708yamaguchi/pr2_fingertip_sensors/scripts/README.md

Here, to avoid duplicate expressions, multiple topic names are summarized by abbreviating them as follows:
  - `{l_r}`: `l` or `r`
  - `{part}`: `pfs_a_front`, `pfs_b_top`, `pfs_b_back`, `pfs_b_left` or `pfs_b_right`
  - `{sensor_num}`: the number of sensors on the each PFS board

# parse_pr2.py

  This node parses PFS sensor data by combining two consecutive topics.

## Subscribe topics

  ROS topics output from PR2 gripper MCB.

  - `/pressure/{l_r}_gripper_motor` (`pr2_msgs/PressureState`)

## Publish topics

  Parsed PFS topics.

  - `/pfs/{l_r}_gripper/{l_r}_fingertip` (`pr2_fingertip_sensors/PR2FingertipSensor`)

# convert_pfs.py

  This node converts parsed PFS data into ROS topics decomposed for each sensor.
  This node publishes
  - force data for each PFS board (6 axis, unit: [N])
  - imu data for each fingertip (6 axis, unit: [rad/s], [m/s^2])
  - proximity data for each sensor (Pointcloud considering the position of each sensor and the distance calculated from the sensor. )
    - Based on the equation: `I = (a/d^2) + b`
    - I: proximity sensor value
    - a: Coefficient on infrared reflectance
    - d: Distance between proximity sensor and object
    - b: Amount of infrared radiation reflected permanently (e.g. Reflection by rubber)

## Subscribe topics

  Parsed PFS topics.

  - `/pfs/{l_r}_gripper/{l_r}_fingertip` (`pr2_fingertip_sensors/PR2FingertipSensor`)

## Publish topics

  ROS topics decomposed for each sensor. `pr2_fingertip_sensors/config/pfs.rviz` visualizes the second, third and fifth topics.

  - `/pfs/{l_r}_gripper/{l_r}_fingertip/{part}/force/{sensor_num}` (`std_msgs/Float32`)

  Force value. One topic per force sensor.

  - `/pfs/{l_r}_gripper/{l_r}_fingertip/{part}/wrench` (`geometry_msgs/WrenchStamped`)

  Wrench value. One topic per PFS board.

  - `/pfs/{l_r}_gripper/{l_r}_fingertip/{part}/imu` (`sensor_msgs/Imu`)

  IMU value. One topic per PFS A board.

  - `/pfs/{l_r}_gripper/{l_r}_fingertip/{part}/proximity_distance/{sensor_num}` (`std_msgs/Float32`)

  Distance calculated from each proximity sensor. One topic per proximity sensor.

  - `/pfs/{l_r}_gripper/{l_r}_fingertip/{part}/proximity_cloud/{sensor_num}` (`sensor_msgs/PointCloud2`)

  Pointcloud calculated from each proximity sensor. One topic per proximity sensor.

## Parameters

  Parameters used to convert PFS sensor data. The default value is saved at `pr2_fingertip_sensors/data/pfs_params.yaml`

  - `/pfs/{l_r}_gripper/{l_r}_fingertip/sensitivity` [float list, 24 elements]
  - `/pfs/{l_r}_gripper/{l_r}_fingertip/preload` [float list, 24 elements]
  - `/pfs/{l_r}_gripper/{l_r}_fingertip/proximity_a` [float list, 24 elements]
  - `/pfs/{l_r}_gripper/{l_r}_fingertip/proximity_b` [float list, 24 elements]

# calibrate_pfs.py

  This ROS node is used only when calibrating each sensor. Calibrate each sensor by calling ROS service.

## Subscribe topics

  Parsed PFS topics.

  - `/pfs/{l_r}_gripper/{l_r}_fingertip` (`pr2_fingertip_sensors/PR2FingertipSensor`)

## Publish topics

None

## Advertise services

### Calibrate proximity sensor

  Calibrate proximity parameters 'b' in I = (a / d^2) + b. Run the following command when nothing is near the PFS finger. The calibration result is saved to rosparam `/pfs/{l_r}_gripper/{l_r}_fingertip/proximity_b`.

  - `/pfs/no_object` (`std_srvs/Empty`)

  Calibrate proximity parameters 'a' in I = (a / d^2) + b. Run the following command after wrapping the PFS finger with white conver. This command must be called after the above command. The calibration result is saved to rosparam `/pfs/{l_r}_gripper/{l_r}_fingertip/proximity_a`.

  - `/pfs/near_object` (`std_srvs/Empty`)

### Calibrate force sensor

  Calibrate force sensor preload. Run the following command when nothing touches the PFS finger. The calibration result is saved to rosparam `/pfs/{l_r}_gripper/{l_r}_fingertip/preload`.

  - `/pfs/preload` (`std_srvs/Empty`)

### Dump calibration params

  Dump calibration rosparams to yaml file (`pr2_fingertip_sensors/data/pfs_params.yaml`).
