708yamaguchi/pr2_fingertip_sensors/CubeIDE/I2C_samples/README.md

Sample program for I2C communication between two Nucleo G491REs.
If using DMA version does not work, press the reset button on Nucleo for slave, then master.
