708yamaguchi/pr2_fingertip_sensors/(threads)

Thread 1 (2022-05-25):

TODO

708yamaguchi, 2022-05-25:
- Change project name (g491_makabe -> ???)
- Add firmware for sensors

makabe0510, 2022-05-25:
プロジェクト名変更 -> .iocや.projectとかの中のプロジェクト名の文字列を手動で書き換える

708yamaguchi, 2022-06-09:
*IMUをI2Cで読んでみる
*暫定で送るフォーマットを決める
*PR2と繋いで試す

makabe0510, 2022-06-10:
金沢君Todo
・Altium Designerのライセンス発行を先生に頼む
・インストールして、チュートリアルを終わらせる

708yamaguchi, 2022-06-13:
> PR2と繋いで試す

ADC、I2C（近接、IMU）、I2S（マイク）を全部読むプログラムはできた。
確かこのコミット：https://github.com/708yamaguchi/pr2_fingertip_sensors/commit/cf0397167bd7113abed8acfd08210ac6ac868af5

ここに、PR2と通信するためのSPIスレーブ機能を加えると上手くいかない。
具体的には、PR2のrostopicから得られる値が安定しない or 何かのセンサが読めていない

試したら良いこと
- FreeRTOSでセンサごとにタスクを作るのではなく、全てメインループに入れてみる（シングルコアなので、あるタスクが別タスク中に実行されてしまうと、通信が失敗することがある）
- メインループにかかる時間を測定する。PR2がセンサデータを読む周期が40msなので、これ以内に収まるかが大事
- メインループは時間がかかりすぎる場合は、`if (i==0); readADC(); else if (i==1) readIMU() ... else sendSPI()`のように、各ループごとに行う処理を分ける
- I2Sだけはタイミングがシビアなので、タイマー割り込みにしても良いかも知れない。

708yamaguchi, 2022-06-13:
FreeRTOSバージョンとシングルスレッドバージョンを簡単に切り替えられるようにする。
できれば、code generationのみ or #define のみで切り替えられるようにする。

708yamaguchi, 2022-06-13:
各センサとの通信をDMAにすると上手く行きそうなので、山口と真壁で自分が使いたいセンサ通信をDMAにする。

原因として考えられるのは、シングルコアのCPUにタスクを振りすぎて、途中で中断したくないセンサ通信までも中断されていたこと。
DMAにするとCPUリソースを使わないので、この問題が解決するかもしれない。

makabe0510, 2022-06-13:
ブレイクポイントを打ってICM-42688-PをI2C+DMAで読むのが一応できました
ただ、UARTでの出力と同居できず、検証を進めた所HAL_I2C_Mem_Read_DMAを呼んだ上で途中でICM-42688-Pからの返信が無くなるようでした
しばらく更新がなかった場合にHAL_I2C_Mem_Read_DMAを呼び直しても通信できませんでした

そのため、なるべく通信時間を軽くする方法を検証した所、通信周波数を最大で1MHzまで挙げられて、その運用で読むことができました
基本的に4000[us]、最悪で20000[us]程度になったようです

708yamaguchi, 2022-06-13:
おー、仕事が早い
さすがです

> ただ、UARTでの出力と同居できず、

まあ本番はUART使わないし、SPIスレーブと同居できたら問題ないね

> なるべく通信時間を軽くする方法を検証した所、通信周波数を最大で1MHzまで挙げられて

これはI2C通信にかかる時間を短くしたということ？

> 基本的に4000[us]、最悪で20000[us]程度になったようです

これはI2C通信+UART通信にかかる時間の合計？

708yamaguchi, 2022-06-13:
了解です
情報共有助かりました。

僕も明日は朝からI2SのDMAやります。

708yamaguchi, 2022-06-14:
I2SマイクのDMA通信 + FreeRTOSをしてみました。
コメントで@makabe0510に質問しているので時間があるときに教えてもらいたいです。
https://github.com/708yamaguchi/pr2_fingertip_sensors/pull/18

あと以下のコメントにあるIMU+DMAのプログラムを、一応プルリクエストにしておいてください。
https://github.com/708yamaguchi/pr2_fingertip_sensors/issues/1#issuecomment-1154057979

708yamaguchi, 2022-06-15:
以下のプルリクエストをもって、マイク以外は安定バージョンになった気がします。
https://github.com/708yamaguchi/pr2_fingertip_sensors/pull/27

@makabe0510
https://github.com/708yamaguchi/pr2_fingertip_sensors/pull/27#issuecomment-1156707926 のコメントにあるように、マイクを安定させるためには他のセンサがマイコンリソースを奪いすぎないことが重要だと自分は考えているので、他のセンサもDMA化したいです。
一方で設計を進めることが最優先だと思うので、発注してから基板が届くまでの間のタスクにするのが良いかなと考えています。

Closed 2022-11-07.

Thread 24 (2022-06-15):

Nucleo G491REでI2S+SPIを3系統全部を使う方法

708yamaguchi, 2022-06-15:
STM32 G491REには、SPIが合計3系統存在する。
そのうちSPI2とSPI3は、I2Sとして利用することも出来る。
https://github.com/708yamaguchi/pr2_fingertip_sensors/blob/master/Datasheets/stm32g491re.pdf

しかしNucleo G491REではSPI1が使えず、SPI1として利用できるピンは他の機能に利用されている。
CubeIDEでNucleo G491REプロジェクトのPinoutを設定するときに表示されるエラーは以下。
```
SPI1:
Serial Peripheral Interface
Status:
Not available:
PA5 mapped with GPIO_Output or/and
PB3 mapped with SYS_JTDO-SWO
```

そこで、CubeIDEでSTM32 G491RE（注：Nucleo G491REではない）用のプロジェクトを作る。
この場合、PA5やPA3に上記の機能を割り当てる必要がなく、SPI1の機能を割り当てることが出来る。
ただし、SYS_JTDO-SWO機能を割り当てていないため、デバッグは行えなくなる。（要検証）

このとき、USB経由ではNucleoに書き込み出来ない（要検証）
しかし、PCにUSB接続したST-LINKとNucleoの間で以下のようにピンを接続することで、書き込みを行える。
このとき、5V_SELのジャンパピンを、5V_STLKからE5Vにすることを忘れない。
- E5V （5Vの給電、Nucleoにはシルクで書かれている）
- GND
- T_SWDIO（初期設定ではPA13）
- T_SWCLK（初期設定ではPA14）

708yamaguchi, 2022-06-16:
> そこで、CubeIDEでSTM32 G491RE（注：Nucleo G491REではない）用のプロジェクトを作る。

Nucleo G491REのプロジェクトを作って、PinoutでSYS_JTDO-SWOをSPI1用に割り当てればよい。

> SYS_JTDO-SWO機能を割り当てていないため、デバッグは行えなくなる。
> USB経由ではNucleoに書き込み出来ない

さっき試した感じだと、おそらく両方USB経由で出来る

makabe0510, 2022-06-16:
今まで4線で試した感じブレイクポイントを打つデバッグはできてました

makabe0510, 2022-06-16:
SWOがあるとprintfデバッグができる感じっぽいです
https://yukblog.net/stm32cubeide-printf-swo/

708yamaguchi, 2022-06-16:
> 今まで4線で試した感じブレイクポイントを打つデバッグはできてました

これUSBでも出来てしまいました。。。

> SWOがあるとprintfデバッグができる感じっぽいです
[yukblog.net/stm32cubeide-printf-swo](https://yukblog.net/stm32cubeide-printf-swo/)

なるほど
SWOはUARTとは関係ないから、SWOピンをdisableしてもUART経由でシリアルモニタに文字を送れるってことね
勉強になります

Closed 2022-06-16.

Thread 25 (2022-06-15):

IMU(I2C)とマイク(I2S)を同時に利用するとデータが読めなくなる

708yamaguchi, 2022-06-15:
解決するために試したこと
- IMUをSPIで読む (Related to https://github.com/708yamaguchi/pr2_fingertip_sensors/issues/24)
- Nucleoから各センサへの電源を、複数の3.3Vピンから供給する（これまでは1つの3.3Vピンから電力を供給しようとしていた。電力不足だったかもしれない）

懸念
- PR2の両指にセンサ基板をつけるとなると、そもそもPR2から供給できる電流(30mA)が少なすぎる可能性がある。
- 開発するセンサ基板は、PR2のgripper boardなどから追加の電力供給を簡単に行えるように、何かしらのピンやビア、パッドを開けておく必要がある。

708yamaguchi, 2022-06-16:
現状、ちゃんと読めるようになったはず
move to https://github.com/708yamaguchi/pr2_fingertip_sensors/pull/31#issuecomment-1157723628

Closed 2022-06-16.

Thread 26 (2022-06-15):

PR2とのSPI slave通信とI2Sマイク通信を同時に行うと、SPI通信に正しい値を送れない

708yamaguchi, 2022-06-15:
SPI slave通信とI2Sマイク通信をともにDMA化すると、SPI通信は安定した（I2S通信で得られる値は不安定）

708yamaguchi, 2022-06-16:
今日アップデートしたバージョンの方が安定しているように見えるので、こちらに移動
https://github.com/708yamaguchi/pr2_fingertip_sensors/pull/31#issuecomment-1157723628

Closed 2022-06-16.

Thread 30 (2022-06-16):

Nucleo G491REで、ADC1とI2S2がコンフリクトしている？

708yamaguchi, 2022-06-16:
以下の画像にあるように、ADC1の何かしらの機能がI2S2とコンフリクトしているように見えます。
実際、UART + SPI slave + I2S + I2Cで上手く通信が出来ていた時にADC1のIN1をIN1 Single-endedにした瞬間に、マイクの値が取れなくなりました。（ADC2をenableしてもマイクの値は取得し続けられる）
```
ADC1:
Analog to digital converter 12-bits

Status:
Partly disabled conflict with:
...(中略)...
I2S2: Mode Half-Duplex Master or/and
```

@makabe0510
これまで一緒に試してたときに、ADCとI2Sマイクの競合チェックってしてないよね？
これもマイクの調子が悪い一因かもしれない。

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

708yamaguchi, 2022-07-20:
今日、@makabe0510と一緒に以下のプロジェクトのADC2をADC1にしましたが、マイク(I2S2)と共存できていました。
https://github.com/708yamaguchi/pr2_fingertip_sensors/tree/master/CubeIDE/Nucleo_G491RE_DMA

僕の勘違いだったと思うので、ADC1, ADC2, ADC3を使った設計をしてもらっても大丈夫です。

Closed 2022-07-20.

Thread 32 (2022-06-16):

Nucleo G491REでGPIO outputをenableすると、I2Sの通信が不安定になる

708yamaguchi, 2022-06-16:
@makabe0510
Nucleo G491REでGPIO outputをenableするとI2Sの通信が不安定になるのですが、心当たりはありますか？
また、そもそも`mpu_write`等でGPIOを使うのは必須ですか？
もし必須ではないならGPIOを使わずに通信できたらいいかなと思っています。

Closed 2022-06-16.

Thread 40 (2022-07-21):

I2Sマイクの結線方法について

708yamaguchi, 2022-07-21:
> SPI slaveについてstmのプロジェクトでいうMISOとこの資料でいうMISOが繋がってるのでいいんだっけ

PR2側もSTM側もMISOとMISOをつなぐといいです

> あとマイクの配線なんだけど、どことどこ繋げばいいんだっけ

STM側のピン -> マイク
GND -> SEL
I2S2_WS (PB12) -> LRCL
I2S2_SD (PB15) -> DOUT
I2S2_CK (PB13) -> BCLK
GND -> GND
3.3V -> 3V

> あとSELECTどうすれば良いかも

SELは、GNDか3.3Vのどちらかに繋げばいいです。
どちらかにつなぐと右の音が取れて左の音が0としてとれ、
もう片方につなぐと左の音が取れて右の音が0としてとれます

cc @makabe0510

Closed 2022-07-21.

Thread 78 (2022-12-10):

PFSをNoeticでも使えるようにしたい

Kanazawanaoaki, 2022-12-10:
ros noeticで動いているhsrにpfsをusb接続で取り付けてセンサ値を読み込もうとしましたが
以下のエラーが発生して動きませんでした．
https://github.com/Kanazawanaoaki/pr2_fingertip_sensors/commit/4d7a9024a0025c88479a229bdb3f43cde6b13a69 のように変更して無理やり一時的に動かすことはできました．noeticで動かすにはcatkin_install_python周りやpythonのモジュール部分を変更する必要があると思うので後で時間がある時に作業しようかなと思います．

```
$ rosrun pr2_fingertip_sensors parse_serial.py -p /dev/ttyACM0
Traceback (most recent call last):
  File "parse_serial.py", line 8, in <module>
    from pr2_fingertip_sensors.msg import PR2FingertipSensor
  File "/home/kanazawa/pr2_fingertip_ws/devel/lib/python3/dist-packages/pr2_fingertip_sensors/__init__.py", line 34, in <module>
    exec(__fh.read())
  File "<string>", line 1, in <module>
ModuleNotFoundError: No module named 'pfs'
```

708yamaguchi, 2023-11-22:
おそらく
https://github.com/708yamaguchi/pr2_fingertip_sensors/pull/91
で解決しているはずで、

僕のnoetic環境では動きました。
```
$ rosrun pr2_fingertip_sensors parse_serial.py -p /dev/ttyACM0
[INFO] [1700666651.725577]: current serial port list: ['/dev/ttyACM0']
[INFO] [1700666651.726811]: Serial<id=0x7faae16c3e50, open=True>(port='/dev/ttyACM0', baudrate=57600, bytesize=8, parity='N', stopbits=1, timeout=None, xonxoff=False, rtscts=False, dsrdtr=False)
```

Closed 2023-11-22.
