708yamaguchi/pr2_fingertip_sensors/CubeIDE/PFS-01/Core/Src/main.c

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
/* Includes ------------------------------------------------------------------*/
#include "main.h"
#include "cmsis_os.h"
#include "usb_device.h"

/* USER CODE BEGIN Includes */
#include "sensor.h"
#include <stdio.h>
#include "usbd_cdc_if.h"
/* USER CODE END Includes */

ADC_HandleTypeDef hadc1;

I2C_HandleTypeDef hi2c1;
I2C_HandleTypeDef hi2c2;
DMA_HandleTypeDef hdma_i2c2_rx;
DMA_HandleTypeDef hdma_i2c2_tx;

I2S_HandleTypeDef hi2s2;

SPI_HandleTypeDef hspi1;
SPI_HandleTypeDef hspi3;
DMA_HandleTypeDef hdma_spi1_rx;
DMA_HandleTypeDef hdma_spi1_tx;

osThreadId ADCTaskHandle;
osThreadId LEDTaskHandle;
osThreadId PSTaskHandle;
osThreadId IMUTaskHandle;
osThreadId SLAVETaskHandle;
/* USER CODE BEGIN PV */
uint8_t rxbuff[1];
uint8_t rxbuff_i2c[1];
/* USER CODE END PV */

void SystemClock_Config(void);
static void MX_GPIO_Init(void);
static void MX_DMA_Init(void);
static void MX_ADC1_Init(void);
static void MX_I2C1_Init(void);
static void MX_I2S2_Init(void);
static void MX_SPI1_Init(void);
static void MX_SPI3_Init(void);
static void MX_I2C2_Init(void);
void StartADCTask(void const * argument);
void StartLEDTask(void const * argument);
void StartPSTask(void const * argument);
void StartIMUTask(void const * argument);
void StartSLAVETask(void const * argument);

/* USER CODE BEGIN PFP */
void mpuWrite(uint8_t, uint8_t);
void ps_select_channel();
void ps_init();
void ps_init_multi();
void imu_init();
void ps_update();
void ps_update_multi();
void imu_update();
void adc_update();
void adc_update_ADS7828();
void sw_update();
uint32_t UART_IsEnabledIT_RX();
uint8_t getlen();
//void ics_init();
//void ics_init_DMA();
void txbuff_update();

/* USER CODE END PFP */

/* USER CODE BEGIN 0 */
int _write(int file, char *ptr, int len)
{
  #if enable_uart_slave
	HAL_UART_Transmit(&huart1,(uint8_t *)ptr,len,HAL_MAX_DELAY);
  #endif
  return len;
}

/* USER CODE END 0 */

/**
  * @brief  The application entry point.
  * @retval int
  */
int main(void)
{
  /* USER CODE BEGIN 1 */
  #if enable_uart_slave
    setbuf(stdout, NULL);
  #endif
  /* USER CODE END 1 */

  /* MCU Configuration--------------------------------------------------------*/

  /* Reset of all peripherals, Initializes the Flash interface and the Systick. */
  HAL_Init();

  /* Configure the system clock */
  SystemClock_Config();

  /* Initialize all configured peripherals */
  MX_GPIO_Init();
  MX_DMA_Init();
  MX_ADC1_Init();
  MX_I2C1_Init();
  MX_I2S2_Init();
  MX_SPI1_Init();
  MX_SPI3_Init();
  MX_USB_Device_Init();
  MX_I2C2_Init();
  /* USER CODE BEGIN 2 */
  sp.board_select = SELECT_PFS_01;
  sp.imu_select = SELECT_ICM_20600;

  sp.spi_slave_flag = 0;

  ps_init(&hi2c1);

  imu_init(&hspi3);

  #if enable_pr2_spi_slave
    // Start SPI slave with PR2
    // HAL_SPI_Receive_DMA should be called at last(?)
    HAL_Delay(100);
    HAL_SPI_Receive_DMA( &hspi1, rxbuff, sizeof(rxbuff));
  #endif

  #if enable_i2c_slave
    HAL_I2C_Slave_Receive_DMA(&hi2c2, (uint8_t*)rxbuff_i2c, 1);
  #endif
  /* USER CODE END 2 */

  /* USER CODE BEGIN RTOS_MUTEX */
  /* add mutexes, ... */
  /* USER CODE END RTOS_MUTEX */

  /* USER CODE BEGIN RTOS_SEMAPHORES */
  /* add semaphores, ... */
  /* USER CODE END RTOS_SEMAPHORES */

  /* USER CODE BEGIN RTOS_TIMERS */
  /* start timers, add new ones, ... */
  /* USER CODE END RTOS_TIMERS */

  /* USER CODE BEGIN RTOS_QUEUES */
  /* add queues, ... */
  /* USER CODE END RTOS_QUEUES */

  /* Create the thread(s) */
  /* definition and creation of ADCTask */
  osThreadDef(ADCTask, StartADCTask, osPriorityNormal, 0, 128);
  ADCTaskHandle = osThreadCreate(osThread(ADCTask), NULL);

  /* definition and creation of LEDTask */
  osThreadDef(LEDTask, StartLEDTask, osPriorityIdle, 0, 128);
  LEDTaskHandle = osThreadCreate(osThread(LEDTask), NULL);

  /* definition and creation of PSTask */
  osThreadDef(PSTask, StartPSTask, osPriorityIdle, 0, 128);
  PSTaskHandle = osThreadCreate(osThread(PSTask), NULL);

  /* definition and creation of IMUTask */
  osThreadDef(IMUTask, StartIMUTask, osPriorityIdle, 0, 128);
  IMUTaskHandle = osThreadCreate(osThread(IMUTask), NULL);

  /* definition and creation of SLAVETask */
  osThreadDef(SLAVETask, StartSLAVETask, osPriorityIdle, 0, 128);
  SLAVETaskHandle = osThreadCreate(osThread(SLAVETask), NULL);

  /* USER CODE BEGIN RTOS_THREADS */
  /* add threads, ... */
  /* USER CODE END RTOS_THREADS */

  /* Start scheduler */
  osKernelStart();

  /* We should never get here as control is now taken by the scheduler */
  /* Infinite loop */
  /* USER CODE BEGIN WHILE */
  while (1)
  {
    /* USER CODE END WHILE */

    /* USER CODE BEGIN 3 */
  }
  /* USER CODE END 3 */
}

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
/* USER CODE BEGIN 4 */
void HAL_SPI_RxCpltCallback(SPI_HandleTypeDef *hspi) {
  if(rxbuff[0] == READ_COMMAND){//as possible as light processing
    // Do not call txbuff_update() before HAL_SPI_Transmit_DMA();
    // There is only 36us for txbuff_update() to be processed
    // due to PR2 Gripper MCB specification
    HAL_SPI_Transmit_DMA(hspi, sp.txbuff_state[sp.spi_slave_flag], TXBUFF_LENGTH);
  }else{
   	HAL_SPI_Receive_DMA(hspi, rxbuff, 1);
  }
}

void HAL_SPI_TxCpltCallback(SPI_HandleTypeDef *hspi) {
    txbuff_update();
    // HAL_Delay(1) is magic number
    HAL_SPI_Receive_DMA(hspi, rxbuff, 1);
}

void HAL_I2C_SlaveRxCpltCallback(I2C_HandleTypeDef *hi2c) {
  if(rxbuff_i2c[0] == READ_COMMAND) {
    HAL_I2C_Slave_Transmit_DMA(hi2c, sp.txbuff_state[sp.spi_slave_flag], TXBUFF_LENGTH);
  }
  else {
    HAL_I2C_Slave_Receive_DMA(hi2c, rxbuff_i2c, sizeof(rxbuff_i2c));
  }
}

void HAL_I2C_SlaveTxCpltCallback(I2C_HandleTypeDef *hi2c) {
  txbuff_update();
  HAL_I2C_Slave_Receive_DMA(hi2c, (uint8_t*)rxbuff_i2c, sizeof(rxbuff_i2c));
}
/* USER CODE END 4 */

/* USER CODE BEGIN Header_StartADCTask */
/**
  * @brief  Function implementing the ADCTask thread.
  * @param  argument: Not used
  * @retval None
  */
/* USER CODE END Header_StartADCTask */
void StartADCTask(void const * argument)
{
  /* USER CODE BEGIN 5 */
  /* Infinite loop */
  for(;;)
  {
	  adc_update(&hadc1);
	  #if board_select == SELECT_PFS_01_ASM
		  adc_update_ADS7828(&hi2c1);
	  #endif
	  osDelay(1);
  }
  /* USER CODE END 5 */
}

/* USER CODE BEGIN Header_StartLEDTask */
/**
* @brief Function implementing the LEDTask thread.
* @param argument: Not used
* @retval None
*/
/* USER CODE END Header_StartLEDTask */
void StartLEDTask(void const * argument)
{
  /* USER CODE BEGIN StartLEDTask */

  /* Infinite loop */
  for(;;)
  {
	  HAL_GPIO_TogglePin(LED_GPIO_Port,LED_Pin);
	  osDelay(50);
  }
  /* USER CODE END StartLEDTask */
}

/* USER CODE BEGIN Header_StartPSTask */
/**
* @brief Function implementing the PSTask thread.
* @param argument: Not used
* @retval None
*/
/* USER CODE END Header_StartPSTask */
void StartPSTask(void const * argument)
{
  /* USER CODE BEGIN StartPSTask */
  /* Infinite loop */
  for(;;)
  {
	ps_update(&hi2c1);
    osDelay(1);
  }
  /* USER CODE END StartPSTask */
}

/* USER CODE BEGIN Header_StartIMUTask */
/**
* @brief Function implementing the IMUTask thread.
* @param argument: Not used
* @retval None
*/
/* USER CODE END Header_StartIMUTask */
void StartIMUTask(void const * argument)
{
  /* USER CODE BEGIN StartIMUTask */
  /* Infinite loop */
  for(;;)
  {
	  imu_update(&hspi3);
	  osDelay(1);
  }
  /* USER CODE END StartIMUTask */
}

/* USER CODE BEGIN Header_StartSLAVETask */
/**
* @brief Function implementing the SLAVETask thread.
* @param argument: Not used
* @retval None
*/
/* USER CODE END Header_StartSLAVETask */
void StartSLAVETask(void const * argument)
{
  /* USER CODE BEGIN StartSLAVETask */
  /* Infinite loop */
  for(;;)
  {
     #if enable_uart_slave || enable_usb_slave
	  txbuff_update();
     #endif
	 #if enable_uart_slave
      HAL_UART_Transmit(&huart1,
    		  (uint8_t *)sp.txbuff_state[sp.spi_slave_flag],
			  TXBUFF_LENGTH,
			  HAL_MAX_DELAY);
	  printf("\r\n");
	 #endif
	 #if enable_usb_slave
      while(CDC_Transmit_FS((uint8_t*)sp.txbuff_state[sp.spi_slave_flag], TXBUFF_LENGTH) == USBD_OK) {}
      char buff[2] = "\r\n";
      osDelay(1);
      while(CDC_Transmit_FS((uint8_t*)buff, sizeof(buff)) == USBD_OK) {}
      osDelay(1);
	 #endif
    osDelay(1);
  }
  /* USER CODE END StartSLAVETask */
}

 /**
  * @brief  Period elapsed callback in non blocking mode
  * @note   This function is called  when TIM1 interrupt took place, inside
  * HAL_TIM_IRQHandler(). It makes a direct call to HAL_IncTick() to increment
  * a global variable "uwTick" used as application time base.
  * @param  htim : TIM handle
  * @retval None
  */
void HAL_TIM_PeriodElapsedCallback(TIM_HandleTypeDef *htim)
{
  if (htim->Instance == TIM1) {
    HAL_IncTick();
  }
}

/**
  * @brief  This function is executed in case of error occurrence.
  * @retval None
  */
void Error_Handler(void)
{
  /* USER CODE BEGIN Error_Handler_Debug */
  /* User can add his own implementation to report the HAL error return state */
  __disable_irq();
  while (1)
  {
  }
  /* USER CODE END Error_Handler_Debug */
}

#ifdef  USE_FULL_ASSERT
/**
  * @brief  Reports the name of the source file and the source line number
  *         where the assert_param error has occurred.
  * @param  file: pointer to the source file name
  * @param  line: assert_param error line source number
  * @retval None
  */
void assert_failed(uint8_t *file, uint32_t line)
{
  /* USER CODE BEGIN 6 */
  /* User can add his own implementation to report the file name and line number,
     ex: printf("Wrong parameters value: file %s on line %d\r\n", file, line) */
  /* USER CODE END 6 */
}
#endif /* USE_FULL_ASSERT */

/************************ (C) COPYRIGHT STMicroelectronics *****END OF FILE****/
