708yamaguchi/pr2_fingertip_sensors/CubeIDE/PFS-01/PFS-01.ioc

Mcu.UserName=STM32G491CCUx
PA0.Signal=ADC1_IN1
PA1.Signal=ADC1_IN2
PA11.Signal=USB_DM
PA12.Signal=USB_DP
PA13.Signal=SYS_JTMS-SWDIO
PA14.Signal=SYS_JTCK-SWCLK
PA15.Signal=I2C1_SCL
PA2.Signal=ADC1_IN3
PA3.Signal=ADC1_IN4
PA4.Signal=SPI1_NSS
PA5.Signal=SPI1_SCK
PA6.Signal=SPI1_MISO
PA7.Signal=SPI1_MOSI
PA8.Signal=I2C2_SDA
PA9.Signal=I2C2_SCL
PB0.Signal=ADC1_IN15
PB1.Signal=ADC1_IN12
PB11.Signal=ADC1_IN14
PB12.Signal=I2S2_WS
PB13.Signal=I2S2_CK
PB14.Signal=ADC1_IN5
PB15.Signal=I2S2_SD
PB3.Signal=SPI3_SCK
PB4.Signal=SPI3_MISO
PB5.Signal=SPI3_MOSI
PB6.GPIO_Label=IMU_nCS
PB6.Signal=GPIO_Output
PB7.Signal=I2C1_SDA
PC11.GPIO_Label=IMU_FSYNC
PC11.Signal=GPIO_Output
PC13.GPIO_Label=Software_RESET
PC13.Signal=GPIO_Input
PC4.GPIO_Label=LED
PC4.Signal=GPIO_Output
PF0-OSC_IN.Signal=RCC_OSC_IN
PF1-OSC_OUT.Signal=RCC_OSC_OUT
