708yamaguchi/pr2_fingertip_sensors/CubeIDE/KJS-03/Core/Src/main.c

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
/* Includes ------------------------------------------------------------------*/
#include "main.h"
#include "cmsis_os.h"

/* USER CODE BEGIN Includes */
#include "ics.h"
/* USER CODE END Includes */

ADC_HandleTypeDef hadc1;

I2C_HandleTypeDef hi2c1;
I2C_HandleTypeDef hi2c2;
I2C_HandleTypeDef hi2c3;

SPI_HandleTypeDef hspi1;
SPI_HandleTypeDef hspi2;

UART_HandleTypeDef huart6;
DMA_HandleTypeDef hdma_usart6_rx;

osThreadId ICSTaskHandle;
osThreadId LEDTaskHandle;
osThreadId IMUTaskHandle;
osThreadId PSTaskHandle;
osThreadId ADCTaskHandle;
osThreadId TXBUFFTaskHandle;
void SystemClock_Config(void);
static void MX_GPIO_Init(void);
static void MX_DMA_Init(void);
static void MX_ADC1_Init(void);
static void MX_I2C1_Init(void);
static void MX_I2C2_Init(void);
static void MX_I2C3_Init(void);
static void MX_SPI1_Init(void);
static void MX_USART6_UART_Init(void);
static void MX_SPI2_Init(void);
void StartICSTask(void const * argument);
void StartLEDTask(void const * argument);
void StartIMUTask(void const * argument);
void StartPSTask(void const * argument);
void StartADCTask(void const * argument);
void StartTXBUFFTask(void const * argument);

/* USER CODE BEGIN PFP */
void mpuWrite(uint8_t, uint8_t);
void ps_select_channel();
void ps_init();
void imu_init();
void ps_update();
void ps_update_single();
void imu_update();
void adc_update();
void sw_update();
void initialise_monitor_handles(void);
uint32_t UART_IsEnabledIT_RX();
uint8_t getlen();
void ics_init();
void ics_init_DMA();
void txbuff_update();

extern uint32_t current_time;
extern uint32_t receive_time1;
extern uint32_t receive_time2;
extern uint32_t receive_time3;
extern uint32_t getUs(void);
extern uint8_t flagRcved;

// dma buffer
static UART_HandleTypeDef *huart_cobs;
#define RX_DMA_WRITE_IDX ( (RX_CIRC_BUF_SZ - ((DMA_Stream_TypeDef *)huart_cobs->hdmarx->Instance)->NDTR) & (RX_CIRC_BUF_SZ - 1) )
//#define RX_DMA_WRITE_IDX ( (RX_CIRC_BUF_SZ - ((DMA_Stream_TypeDef *)huart6.hdmarx->Instance)->NDTR) & (RX_CIRC_BUF_SZ - 1) )

/* USER CODE END PFP */

/* USER CODE BEGIN 0 */
//static uint16_t ADC_Data1[ADC_CHANNEL_NUM];
/* USER CODE END 0 */

/**
  * @brief  The application entry point.
  * @retval int
  */
int main(void)
{
  /* MCU Configuration--------------------------------------------------------*/

  /* Reset of all peripherals, Initializes the Flash interface and the Systick. */
  HAL_Init();

  /* Configure the system clock */
  SystemClock_Config();

  /* Initialize all configured peripherals */
  MX_GPIO_Init();
  MX_DMA_Init();
  MX_ADC1_Init();
  MX_I2C1_Init();
  MX_I2C2_Init();
  MX_I2C3_Init();
  MX_SPI1_Init();
  MX_USART6_UART_Init();
  MX_SPI2_Init();
  /* USER CODE BEGIN 2 */

  sp.id = 19;

  sp.mode = SC_ALL;//initial value, update all sensor

  sp.board_select = SELECT_revA;
  sp.imu_select = SELECT_ICM_20600;

  sp.it_count = 0;
  sp.uart_error_count = 0;
  sp.check2com_delay = 0;
  sp.count_frame = 0;
  sp.prev_frame = getUs();
  sp.com_en = 0;
  sp.ics_timeout_count = 0;

#if USE_SEMIHOSTING
  initialise_monitor_handles();
#endif

	ics_init_DMA(&huart6);

   if (HAL_ADC_Start(&hadc1) !=  HAL_OK)
   {
  	  Error_Handler();
    }
  	//ics_init(&huart6);

    ps_init(&hi2c2);

    imu_init(&hspi1);

    //receive_time1 = receive_time2 = receive_time3 = getUs();

    //receive_time1: past toggle time
    //receive_time2: past uart_rx interrupt time
    //receive_time3: past receive ics command time

    HAL_HalfDuplex_EnableReceiver(&huart6);
  /* USER CODE END 2 */

  /* USER CODE BEGIN RTOS_MUTEX */
  /* add mutexes, ... */
  /* USER CODE END RTOS_MUTEX */

  /* USER CODE BEGIN RTOS_SEMAPHORES */
  /* add semaphores, ... */
  /* USER CODE END RTOS_SEMAPHORES */

  /* USER CODE BEGIN RTOS_TIMERS */
  /* start timers, add new ones, ... */
  /* USER CODE END RTOS_TIMERS */

  /* USER CODE BEGIN RTOS_QUEUES */
  /* add queues, ... */
  /* USER CODE END RTOS_QUEUES */

  /* Create the thread(s) */
  /* definition and creation of ICSTask */
  osThreadDef(ICSTask, StartICSTask, osPriorityHigh, 0, 1000);
  ICSTaskHandle = osThreadCreate(osThread(ICSTask), NULL);

  /* definition and creation of LEDTask */
  osThreadDef(LEDTask, StartLEDTask, osPriorityIdle, 0, 128);
  LEDTaskHandle = osThreadCreate(osThread(LEDTask), NULL);

  /* definition and creation of IMUTask */
  osThreadDef(IMUTask, StartIMUTask, osPriorityIdle, 0, 128);
  IMUTaskHandle = osThreadCreate(osThread(IMUTask), NULL);

  /* definition and creation of PSTask */
  osThreadDef(PSTask, StartPSTask, osPriorityIdle, 0, 128);
  PSTaskHandle = osThreadCreate(osThread(PSTask), NULL);

  /* definition and creation of ADCTask */
  osThreadDef(ADCTask, StartADCTask, osPriorityIdle, 0, 128);
  ADCTaskHandle = osThreadCreate(osThread(ADCTask), NULL);

  /* definition and creation of TXBUFFTask */
  osThreadDef(TXBUFFTask, StartTXBUFFTask, osPriorityIdle, 0, 128);
  TXBUFFTaskHandle = osThreadCreate(osThread(TXBUFFTask), NULL);

  /* USER CODE BEGIN RTOS_THREADS */
  /* add threads, ... */
  /* USER CODE END RTOS_THREADS */

  /* Start scheduler */
  osKernelStart();

  /* We should never get here as control is now taken by the scheduler */
  /* Infinite loop */
  /* USER CODE BEGIN WHILE */
  while (1)
  {
    /* USER CODE END WHILE */

    /* USER CODE BEGIN 3 */
  }
  /* USER CODE END 3 */
}

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
/* USER CODE BEGIN 4 */
void HAL_UART_ErrorCallback_old(UART_HandleTypeDef *huart){
	sp.uart_error[0] = huart6.Lock;
	sp.uart_error[1] = huart6.gState;
	sp.uart_error[2] = huart6.RxState;
	sp.uart_error[3] = huart6.ErrorCode & 0x000000ff;
  //MX_GPIO_Init();
  HAL_UART_Abort(&huart6);
	//start HAL_UART_Abort
	//CLEAR_BIT(huart->Instance->CR1, (USART_CR1_RXNEIE | USART_CR1_PEIE | USART_CR1_TXEIE | USART_CR1_TCIE));
	//CLEAR_BIT(huart->Instance->CR3, USART_CR3_EIE);
	//end HAL_UART_Abort
  //MX_USART6_UART_Init();
  //CLEAR_BIT(huart->Instance->SR, (USART_SR_PE | USART_SR_FE | USART_SR_ORE | USART_SR_NE));
  //CLEAR_BIT(huart->Instance->SR, (USART_SR_ORE));

  //CLEAR_BIT(huart->Instance->CR1, (USART_CR1_RXNEIE | USART_CR1_PEIE));//minimum reset + RX_It reset
  //CLEAR_BIT(huart->Instance->CR1, (USART_CR1_PEIE));//minimum reset
  //huart6.RxState=HAL_UART_STATE_READY;
  //huart6.ErrorCode=HAL_UART_ERROR_NONE;
  //__HAL_UART_DISABLE_IT(huart, UART_IT_ERR);
  //  MX_I2C2_Init();
  //  ps_init(&hi2c1);
  HAL_HalfDuplex_EnableReceiver(&huart6);
  flagRcved = IT_FLAG_FALSE;

  if(sp.uart_error_count < 4096){
	  sp.uart_error_count += 1;
  }
  //sp.mode = SC_ALL; //initial value, update all sensor
  //NVIC_SystemReset();
}
void HAL_I2C_ErrorCallback(I2C_HandleTypeDef *hi2c){
  MX_GPIO_Init();
  MX_I2C2_Init();
  ps_init(&hi2c2);
  //sp.mode = SC_ALL; //initial value, update all sensor
}
void HAL_ADC_ErrorCallback(ADC_HandleTypeDef *hadc){
  MX_GPIO_Init();
  MX_ADC1_Init();
  if (HAL_ADC_Start(&hadc1) !=  HAL_OK)
    {
      Error_Handler();
    }
  //sp.mode = SC_ALL; //initial value, update all sensor
}
void HAL_SPI_ErrorCallback(SPI_HandleTypeDef *hspi){
  MX_GPIO_Init();
  MX_SPI1_Init();
  imu_init(&hspi1);
  //sp.mode = SC_ALL; //initial value, update all sensor
}

void ics_init_DMA(UART_HandleTypeDef *huart)
{
    huart_cobs = huart;
    memset(sp.rx_dma_circ_buf, 0, sizeof(sp.rx_dma_circ_buf));

    __HAL_UART_DISABLE_IT(huart_cobs, UART_IT_PE);//parity error interrupt
    __HAL_UART_DISABLE_IT(huart_cobs, UART_IT_ERR);//other error interrupt

    __HAL_UART_DISABLE_IT(huart_cobs, UART_IT_TXE); //txe interrupt
    __HAL_UART_DISABLE_IT(huart_cobs, UART_IT_TC); //transmission complete interrupt

    HAL_HalfDuplex_EnableTransmitter(huart_cobs);
    HAL_UART_Receive_DMA(huart_cobs, sp.rx_dma_circ_buf, RX_CIRC_BUF_SZ);
    memset(sp.txbuff, 0, sizeof(sp.txbuff));
    sp.txbuff[0] = 0x20 | sp.id;
    sp.rd_idx = 0;
}

void HAL_UART_ErrorCallback(UART_HandleTypeDef *huart)
{
	sp.uart_error[0] = huart6.Lock;
	sp.uart_error[1] = huart6.gState;
	sp.uart_error[2] = huart6.RxState;
	sp.uart_error[3] = huart6.ErrorCode & 0x000000ff;
	memset(sp.rx_dma_circ_buf, 0, sizeof(sp.rx_dma_circ_buf));

	HAL_UART_Abort(huart);

	if(sp.uart_error_count < 4096){
		sp.uart_error_count += 1;
	}else{
		sp.uart_error_count = 0;
	}
	//HAL_HalfDuplex_EnableReceiver(&huart6);
	HAL_HalfDuplex_EnableReceiver(huart_cobs);
	HAL_UART_Receive_DMA(huart_cobs, sp.rx_dma_circ_buf, RX_CIRC_BUF_SZ);
	sp.rd_idx = 0;
	//	_Error_Handler("isrSensors.c, uart error",53);
}
/* USER CODE END 4 */

/* USER CODE BEGIN Header_StartICSTask */
/**
  * @brief  Function implementing the ICSTask thread.
  * @param  argument: Not used
  * @retval None
  */
/* USER CODE END Header_StartICSTask */
void StartICSTask(void const * argument)
{
  /* USER CODE BEGIN 5 */
	uint8_t sensor_flag;
	uint8_t ret;
	uint8_t tx_length;
  /* Infinite loop */
  for(;;)
  {
	  sp.count_frame = getUs() - sp.prev_frame;
	  if (__HAL_UART_GET_FLAG(&huart6, UART_FLAG_ORE) ||
			  __HAL_UART_GET_FLAG(&huart6, UART_FLAG_NE) ||
			  __HAL_UART_GET_FLAG(&huart6, UART_FLAG_FE) ||
			  __HAL_UART_GET_FLAG(&huart6, UART_FLAG_PE) ){
		  HAL_UART_Abort(&huart6);
	  }
	  if((sp.count_frame > UART_TIMEOUT_TIME) & (sp.com_en == 0x01)){
		  //NVIC_SystemReset();
		  sp.com_en = 0x00;
		  sp.it_count = 0;
		  sp.ics_timeout_count += 1;
		  HAL_UART_ErrorCallback(&huart6);
	  }
	  if (sp.rd_idx == RX_DMA_WRITE_IDX){
		  osDelay(1);
	  }else{
	  	  sp.rxbuff[0] = sp.rx_dma_circ_buf[sp.rd_idx++];//
	  	  sp.rd_idx &= (RX_CIRC_BUF_SZ - 1);//128 = 0
	  	  if(((sp.rxbuff[0] & 0xE0) == 0xA0) && (sp.rxbuff[0] & 0x1f) == sp.id){
	  		  sp.prev_frame = getUs();
		  	  sp.rxbuff[1] = sp.rx_dma_circ_buf[sp.rd_idx++];//
		  	  sp.rd_idx &= (RX_CIRC_BUF_SZ - 1);//128 = 0
	  		  sensor_flag = sp.rxbuff[1];
	  		  if ((sensor_flag & SC_NONE) == SC_NONE){
	  			  sp.mode = sensor_flag;
	  			  if(sp.it_count < 4096){
	  				  sp.it_count += 1;
				  }else{
					  sp.it_count = 0;
				  }
			  }
	  		  if((sp.it_count == 1) & (sp.check2com_delay == 0)){
	  			  sp.check2com_delay = sp.prev_frame;
	  		  }
	  		  if((sp.it_count == COM_EN_IT_NUM) & (sp.com_en == 0x00)){
	  			  sp.check2com_delay = getUs() - sp.check2com_delay;
  				  sp.com_en |= 0x01;
	  		  }
	  		  sp.txbuff[1] = sensor_flag;
	  		  tx_length = getlen(sp.mode);
	  		  //taskENTER_CRITICAL();
	  		  for(int i = 0; i < MAX_TXBUFF_LEN; i++) {
	  			  sp.txbuff[i] &= 0x7f;
	  		  }
	  		  HAL_HalfDuplex_EnableTransmitter(&huart6);
	  		  ret = HAL_UART_Transmit(&huart6, sp.txbuff, tx_length, HAL_MAX_DELAY);
	  		  //HAL_UART_Transmit_IT(&huart6, sp.txbuff, tx_length);
	  		  HAL_HalfDuplex_EnableReceiver(&huart6);
	  		  //taskEXIT_CRITICAL();
			  }
	  	  }
  }
  /* USER CODE END 5 */
}

/* USER CODE BEGIN Header_StartLEDTask */
/**
* @brief Function implementing the LEDTask thread.
* @param argument: Not used
* @retval None
*/
/* USER CODE END Header_StartLEDTask */
void StartLEDTask(void const * argument)
{
  /* USER CODE BEGIN StartLEDTask */
  /* Infinite loop */
  for(;;)
  {
	  	if(sp.com_en == 0x01){
	  		HAL_GPIO_TogglePin(LED_PORT,LED_PIN);
	  	}
	    osDelay(100);
	  //if (current_time - receive_time1 > LED_TOGGLE_TIME) {
	  //receive_time1 = current_time;
	  //}
  }
  /* USER CODE END StartLEDTask */
}

/* USER CODE BEGIN Header_StartIMUTask */
/**
* @brief Function implementing the IMUTask thread.
* @param argument: Not used
* @retval None
*/
/* USER CODE END Header_StartIMUTask */
void StartIMUTask(void const * argument)
{
  /* USER CODE BEGIN StartIMUTask */
  /* Infinite loop */
  for(;;)
  {
	  if(((sp.mode & SC_GYRO) == SC_GYRO) || ((sp.mode & SC_ACC) == SC_ACC)){
		  imu_update(&hspi1);
	  }
    osDelay(1);
  }
  /* USER CODE END StartIMUTask */
}

/* USER CODE BEGIN Header_StartPSTask */
/**
* @brief Function implementing the PSTask thread.
* @param argument: Not used
* @retval None
*/
/* USER CODE END Header_StartPSTask */
void StartPSTask(void const * argument)
{
  /* USER CODE BEGIN StartPSTask */
  /* Infinite loop */
  for(;;)
  {
	  if((sp.mode & SC_PS) == SC_PS){
		  ps_update(&hi2c2);
	  }

    osDelay(1);
  }
  /* USER CODE END StartPSTask */
}

/* USER CODE BEGIN Header_StartADCTask */
/**
* @brief Function implementing the ADCTask thread.
* @param argument: Not used
* @retval None
*/
/* USER CODE END Header_StartADCTask */
void StartADCTask(void const * argument)
{
  /* USER CODE BEGIN StartADCTask */
  /* Infinite loop */
  for(;;)
  {
	 if((sp.mode & SC_SW_ADC) == SC_SW_ADC){
		 adc_update(&hadc1);
	 }
	 osDelay(1);
  }
  /* USER CODE END StartADCTask */
}

/* USER CODE BEGIN Header_StartTXBUFFTask */
/**
* @brief Function implementing the TXBUFFTask thread.
* @param argument: Not used
* @retval None
*/
/* USER CODE END Header_StartTXBUFFTask */
void StartTXBUFFTask(void const * argument)
{
  /* USER CODE BEGIN StartTXBUFFTask */
  /* Infinite loop */
  for(;;)
  {
	txbuff_update();
    osDelay(1);
  }
  /* USER CODE END StartTXBUFFTask */
}

 /**
  * @brief  Period elapsed callback in non blocking mode
  * @note   This function is called  when TIM1 interrupt took place, inside
  * HAL_TIM_IRQHandler(). It makes a direct call to HAL_IncTick() to increment
  * a global variable "uwTick" used as application time base.
  * @param  htim : TIM handle
  * @retval None
  */
void HAL_TIM_PeriodElapsedCallback(TIM_HandleTypeDef *htim)
{
  if (htim->Instance == TIM1) {
    HAL_IncTick();
  }
}

/**
  * @brief  This function is executed in case of error occurrence.
  * @retval None
  */
void Error_Handler(void)
{
  /* USER CODE BEGIN Error_Handler_Debug */
  /* User can add his own implementation to report the HAL error return state */
  __disable_irq();
  while (1)
  {
  }
  /* USER CODE END Error_Handler_Debug */
}

#ifdef  USE_FULL_ASSERT
/**
  * @brief  Reports the name of the source file and the source line number
  *         where the assert_param error has occurred.
  * @param  file: pointer to the source file name
  * @param  line: assert_param error line source number
  * @retval None
  */
void assert_failed(uint8_t *file, uint32_t line)
{
  /* USER CODE BEGIN 6 */
  /* User can add his own implementation to report the file name and line number,
     ex: printf("Wrong parameters value: file %s on line %d\r\n", file, line) */
  /* USER CODE END 6 */
}
#endif /* USE_FULL_ASSERT */

/************************ (C) COPYRIGHT STMicroelectronics *****END OF FILE****/
