708yamaguchi/pr2_fingertip_sensors/CubeIDE/PFS-01/Core/Inc/main.h

#define SELECT_PFS_01 SELECT_PFS_01_ASM; // comment in when assembly board
#define enable_pr2_spi_slave 1 // enable or not PR2 slave
#define enable_uart_slave 0 // enable or not UART serial slave
#define enable_usb_slave 0 // enable or not USB serial slave
#define enable_i2c_slave 0 // enable or not USB serial slave
#define Software_RESET_Pin GPIO_PIN_13
#define Software_RESET_GPIO_Port GPIOC
#define LED_Pin GPIO_PIN_4
#define LED_GPIO_Port GPIOC
#define IMU_FSYNC_Pin GPIO_PIN_11
#define IMU_FSYNC_GPIO_Port GPIOC
#define IMU_nCS_Pin GPIO_PIN_6
#define IMU_nCS_GPIO_Port GPIOB
