708yamaguchi/pr2_fingertip_sensors/(commit log)

2022-05-25 Nucleo G491RE firmware for PR2 fingertip
2022-06-01 [CubeIDE/Nucleo_G491RE] add sensor.c/h
2022-06-01 [CubeIDE/Nucleo_G491RE] add imu_init and imu_update function
2022-06-01 [CubeIDE/Nucleo_G491RE] update imu_init function and mpuRead function
2022-06-01 [CubeIDE/Nucleo_G491RE] fix SPI2 pin assign
    [Nucleo_G491RE.ioc]
2022-06-08 Add stm32 and nucleo datasheets
2022-06-09 Use FreeRTOS and Timer job
2022-06-09 [CubeIDE/Nucleo_G491] disable SPI2 and tested I2S with Timer
2022-06-09 Rename project for PR2 SPI slave
2022-06-09 [Nucleo_G491RE] tested imu (not working...)
    [Nucleo_G491RE.ioc, main.c, sensor.c, sensor.h]
2022-06-10 [CubeIDE/Nucleo_G491RE] add imu_update_i2c
2022-06-10 Print all sensor data with keeping format
2022-06-10 Use SPI3 as PR2 fingertip's SPI Slave
2022-06-10 [CubeIDE/Nucleo_G491RE] tested IMU and PS and ADC
2022-06-10 [CubeIDE/Nucleo_G491RE] succeded send ADC and PS values with PR2
2022-06-10 [CubeIDE/Nucleo_G491RE] succeded send IMU values with PR2
2022-06-10 [CubeIDE/Nucleo_G491RE] succeded send IMU values with PR2 and plugging
2022-06-10 [CubeIDE/Nucleo_G491RE] succeded read all sensors (unstable)
    [Nucleo_G491RE.ioc, main.c, sensor.c, sensor.h]
2022-06-10 [CubeIDE/Nucleo_G491RE] dont work (IMU or MIC only work)
2022-06-13 [CubeIDE/Nucleo_G491RE] add flags for change sensor update and communication settings
2022-06-13 [CubeIDE/Nucleo_G491RE] work without imu
2022-06-13 [CubeIDE/Nucleo_G491RE] enabled SPI transmit DMA
2022-06-13 [CubeIDE/Nucleo_G491RE] change i2c communication speed
2022-06-14 Use HAL_I2S_Receive_DMA() in single thread mode, instead of FreeRTOS timer
2022-06-14 Use HAL_I2S_Receive_DMA() in FreeRTOS multi thread mode
2022-06-14 [CubeIDE/Nucleo_G491RE_VCNL4040] enabled vcnl i2c receive DMA
2022-06-14 Use FreeRTOS multi thread mode for Nucleo_G491RE_VCNL4040
2022-06-14 Add sample for Arduino Nano to work as PR2 SPI slave
2022-06-14 Add expected result of Arduino Nano
2022-06-15 [CubeIDE/Nucleo_G491RE] start merge I2S and I2C DMA
2022-06-15 [CubeIDE/Nucleo_G491RE] enables I2S DMA Receive
2022-06-15 [CubeIDE/Nucleo_G491RE] except IMU worked
2022-06-15 [CubeIDE/Nucleo_G491RE] add settings to change IMU ODR
2022-06-15 [CubeIDE/Nucleo_G491RE] tested SPI1 10.625mbps (not working)
    [Nucleo_G491RE.ioc, main.c, main.h, sensor.c, sensor.h]
2022-06-15 [CubeIDE/Nucleo_G491RE] succeeded send all sensor data
2022-06-15 I2S DMA with SPI slave DMA
2022-06-15 Use SPI dma callback only for SPI3
2022-06-16 [WIP] Change main program using dma
2022-06-16 Enable SPI1 and GPIO for IMU
2022-06-16 Read SPI IMU without DMA
2022-06-16 Create ADCTask. Currently, ADC does not use DMA.
2022-06-16 Send sensor data via UART DMA
2022-06-16 Divide imu_update() into acc_update() and gyro_update()
2022-06-16 Add if for each SPI interface
2022-06-16 Read SPI IMU with DMA
2022-06-16 Tunings for stable sensor reading and spi slave
2022-06-19 Add BOM
2022-07-04 [PFS-01] add sensor.c/h copy from Nucleo_G491RE_DMA
2022-07-23 [PFS-01] update Pin settings for real PCB
2022-08-11 [CubeIDE/PFS-01] add Software_reset Pin
2022-09-11 [CubeIDE/PFS-01A] test LED blink
2022-09-11 [CubeIDE/PFS-01A] add PSTask and IMUTask, change IF Parametors, enabeled HSE
2022-09-11 [CubeIDE/PFS-01A] testes ADC 8ch
2022-09-11 [CubeIDE/PFS-01A] change ADC sampling tycle to 94.5
2022-09-14 [CubeIDE/PFS-01A] add board selection function and refactor functions
2022-09-14 [CubeIDE/PFS-01A] tested ICM-20600 and add imu_update function
2022-09-14 [CubeIDE/PFS-01A] add ADS7828 update function (communication is succeed but correct value isn't coming)
    [main.c, sensor.c, sensor.h]
2022-09-15 Send PS, ADC and IMU data to PR2 via SPI DMA
2022-09-15 Fix check_sum calculation in STM32
    [sensor.c]
2022-09-15 Add usage to parse pfs sensor data
2022-09-16 Revert "Merge pull request #55 from 708yamaguchi/fix-flatten"
    This reverts commit 0797171fabd513d2fafb38245ce0de4af8e73817, reversing
    changes made to 82d92628871867937bc4db3f4dd76308d211f2be.
    [sensor.c]
2022-09-16 Revert "Merge pull request #54 from 708yamaguchi/fix-flatten"
    This reverts commit 82d92628871867937bc4db3f4dd76308d211f2be, reversing
    changes made to 52b5f1460521851a23620cc204cec562ca7fe22d.
    [sensor.c]
2022-09-16 Add board_select to footer
2022-09-19 Use uint value for proximity and force sensors
2022-10-30 Publish /tf for pfs sensors
2022-10-30 Add frame_id to parse_pfs.py
2022-10-30 Add nodes to calibrate and convert PFS sensor data
2022-11-02 Visualize PFS sensor data
2022-11-02 Add IMU Visualization
2022-11-03 Add PFS calibration system
2022-11-03 Fix force bug and set reliable proximity cloud
    [convert_pfs.py]
2022-11-03 Add force sensor calibration
2022-11-06 [CubeIDE/PFS-01] update main circuit sensor index
2022-11-07 Fix each sensor position
2022-11-07 Update doc about proximity and force sensor placement and index
2022-11-07 Publish proximity distance and force for each sensor
2022-11-08 Update doc about distance calculation using proximity sensor
2022-11-08 Warn when there is 0 preload force sensor
2022-11-08 Load pfs sensor params in calibrate_pfs.launch
2022-11-24 Print error finger
2022-11-24 Print loaded pfs params
2022-11-24 Update RViz config for each force sensor
2022-12-04 [CubeIDE/PFS-01] Support serial communication via UART connection
2022-12-04 [CubeIDE/PFS-01] Minor fixes for merge
    [main.c]
2022-12-07 Do not send unused characters in UART and USB
2022-12-07 Parse sensor data from UART and USB
2022-12-08 Fix bug: fix acc and gyro order when parsing packet
2022-12-08 Get PFS data via serial(UART)
2022-12-09 Automatically create arduino libraries symbolic links
2022-12-14 Add Nucleo sample programs to use I2C master and slave
2022-12-14 Move Nucleo I2C files to IC_samples directory
2022-12-14 Add sample program for M5Stack I2C master
2022-12-16 Add sample: PFS I2C slave
2022-12-16 Add sample: PFS I2C slave with DMA
2022-12-16 Call setbuf(stdout, NULL) only when UART mode is enabled
2022-12-16 Add I2C slave mode to PFS project
2022-12-16 Rename arduino firmware
2022-12-16 Add program to receive PFS sensor data via I2C
2022-12-16 Add arduino firmware to publish PFS sensor data via I2C
2022-12-16 Integrate receive I2C/UART sketches
2022-12-16 Integrate publish I2C/UART sketches
2022-12-19 Mute M5Stack speaker to avoid noise
    [publish_PFS.ino]
2022-12-21 Read multiple PFS data via I2C, but Serial does not work...
    [publish_PFS.ino, receive_PFS.ino]
2022-12-21 Publish PFS data from different topics for multiple I2C
2022-12-21 Use slave address for topic name and frame id
2023-11-22 Remove '/' in frame_id for noetic
2023-11-29 Add rosparam pfs_frame and imu_frame
2023-11-29 Set imu frame_id
