708yamaguchi/pr2_fingertip_sensors/(notices)

Notices in the files:
CubeIDE/KJS-03/Core/Src/main.c:
© Copyright (c) 2021 STMicroelectronics.
All rights reserved.
This software component is licensed by ST under BSD 3-Clause license,
the "License"; You may not use this file except in compliance with the
License. You may obtain a copy of the License at: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
CubeIDE/PFS-01/Core/Src/main.c:
© Copyright (c) 2022 STMicroelectronics.
